paulwkn/24Vfischer/README.md

# 24Vfischer
In diesem Repository befinden sich alle Dateien zum Projekt "24V Fischer"
Der Adapter ermöglicht den Betrieb des Fischer Technik Roboters mit einer handelsüblichen SPS mit 24V I/Os.
