paulwkn/24Vfischer/(list of files, cad)

Other CAD files:
Fusion360/Fischer Technik v16.f3d
